hallgeirl/coffee-roaster/(commit log)

2019-09-10 arduino code and readme
2019-09-22 Probe placement
2019-10-09 Better precision, fix update interval,include modbus rtu library
    [roaster.ino]
2019-10-11 updated schematics
2019-12-22 cleanup and fix async readings
    [roaster.ino]
2019-12-26 Include the max6675 lib in the project for modification. Include the modbus library in the project for simplicity (it doesn't exist in the library manager)
    [ModbusRtu.h, max6675.cpp, max6675.h, roaster.ino]
2020-02-29 add unfiltered temperature
2021-03-21 readme and capacity planning for v2
